ManoDaSilva/rs41_breakout/rs41_breakout_pcb/rs41_breakout_pcb.kicad_sch

## KiCad design rs41_breakout_pcb/rs41_breakout_pcb.kicad_sch (2026-10-14)

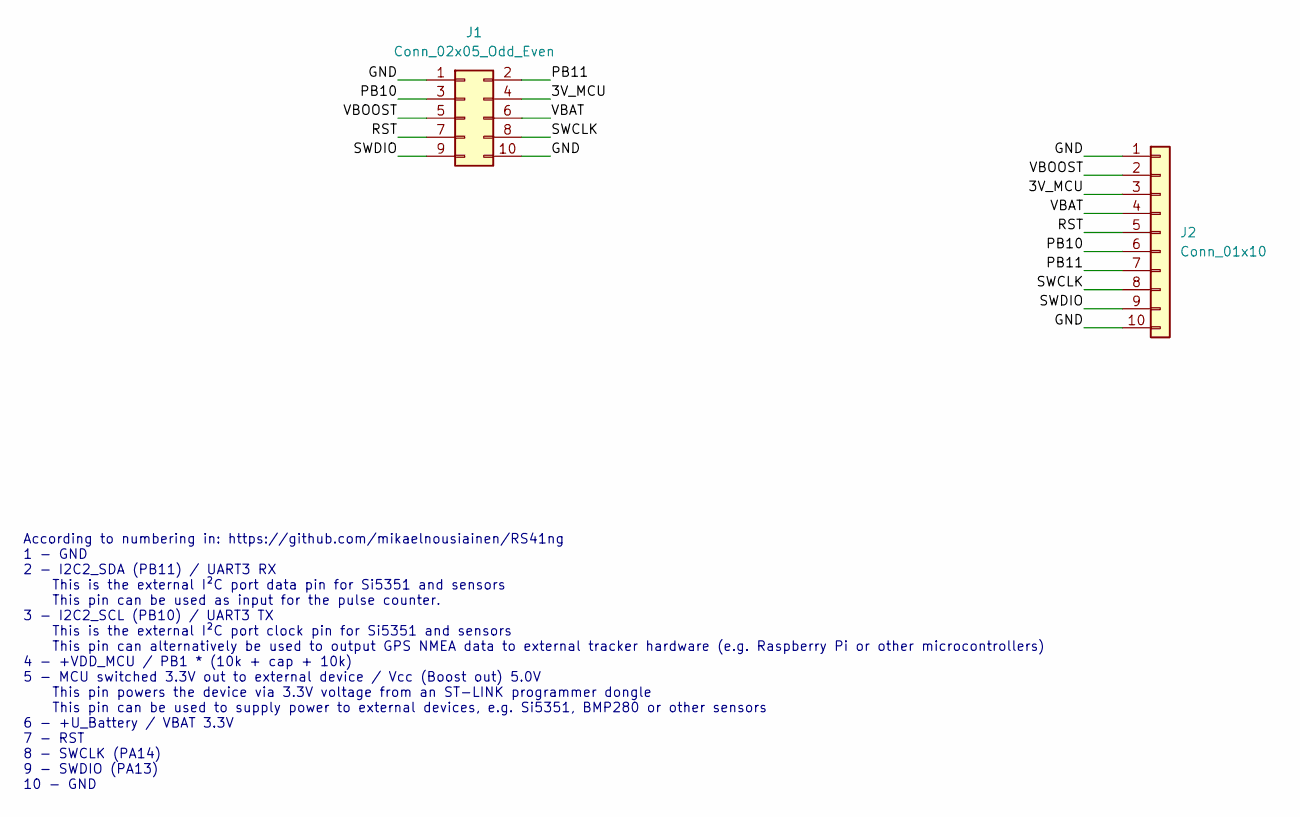
[picture p1: schematic rs41_breakout_pcb.kicad_sch]

Parts:
J1: Conn_02x05_Odd_Even; PinHeader_2x05_P2.00mm_Vertical
J2: Conn_01x10; PinHeader_1x10_P2.54mm_Vertical

Connections:
3V_MCU: J1.4, J2.3
GND: J1.1, J1.10, J2.1, J2.10
PB10: J1.3, J2.6
PB11: J1.2, J2.7
RST: J1.7, J2.5
SWCLK: J1.8, J2.8
SWDIO: J1.9, J2.9
VBAT: J1.6, J2.4
VBOOST: J1.5, J2.2

Notes on the sheet:
According to numbering in: https://github.com/mikaelnousiainen/RS41ng 1 - GND 2 - I2C2_SDA (PB11) / UART3 RX This is the external I²C port data pin for Si5351 and sensors This pin can be used as input for the pulse counter. 3 - I2C2_SCL (PB10) / UART3 TX This is the external I²C port clock pin for 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
